RobbyV2/meenie_controller/docs/first-article/2026-10-17-nextpcb-sample/01-bottom-d3-polarity-marked.png

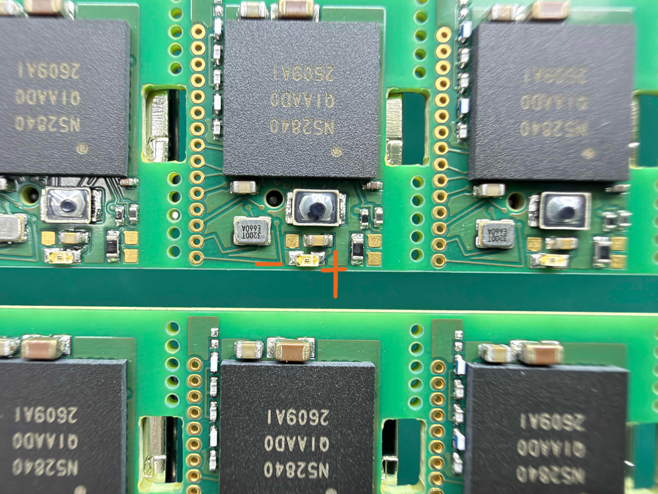
docs/first-article/2026-10-17-nextpcb-sample/01-bottom-d3-polarity-marked.png
