RobbyV2/meenie_controller/docs/first-article/2026-10-17-nextpcb-sample/02-bottom-closeup-a.png

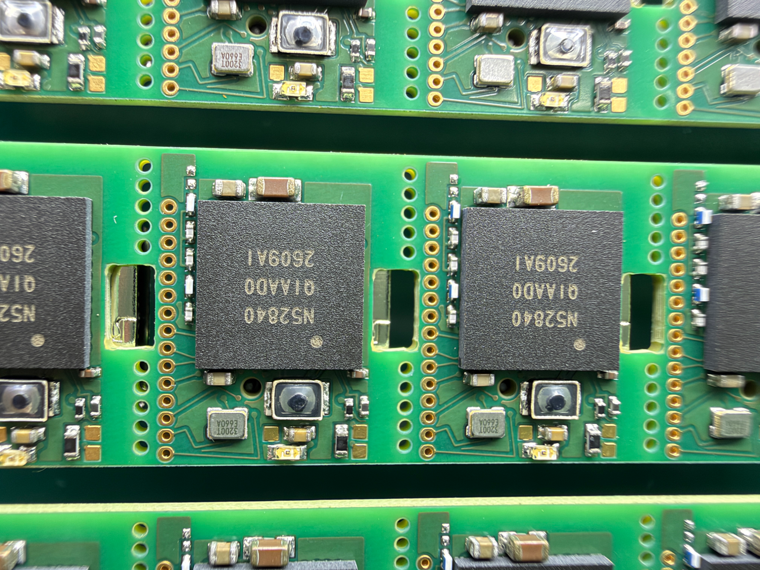
docs/first-article/2026-10-17-nextpcb-sample/02-bottom-closeup-a.png
