RobbyV2/meenie_controller/docs/first-article/2026-10-17-nextpcb-sample/03-bottom-closeup-b.png

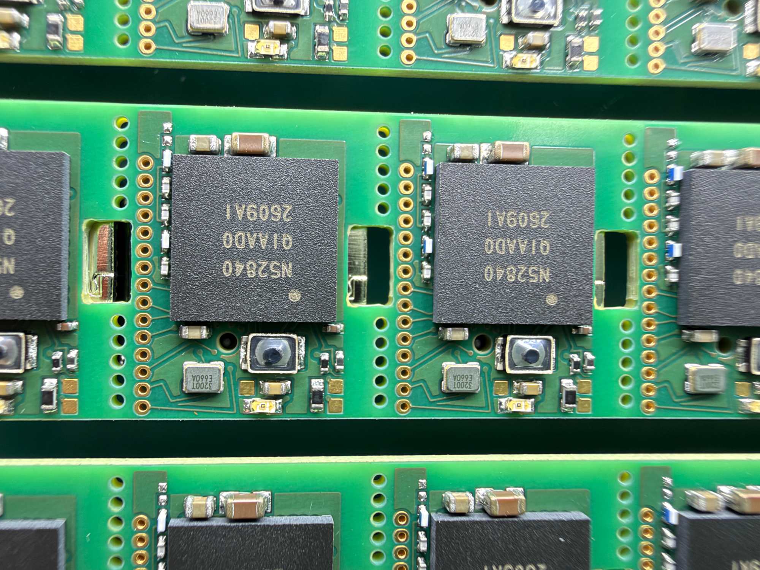
docs/first-article/2026-10-17-nextpcb-sample/03-bottom-closeup-b.png
