RobbyV2/meenie_controller/docs/first-article/2026-10-17-nextpcb-sample/04-bottom-panel.png

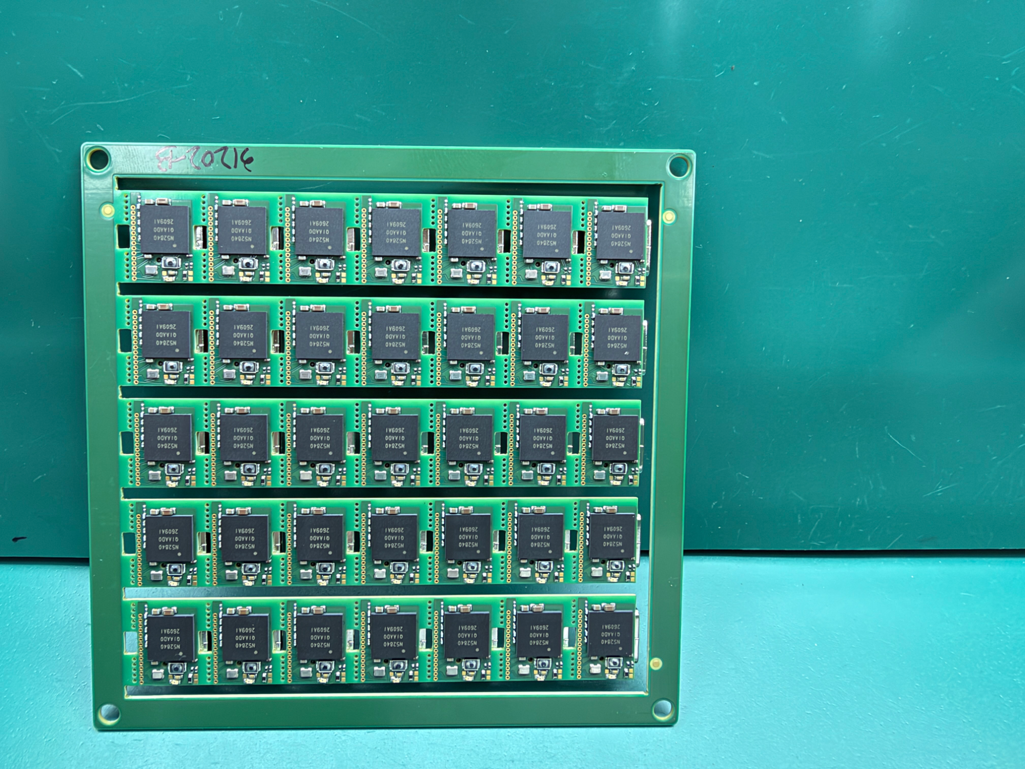
docs/first-article/2026-10-17-nextpcb-sample/04-bottom-panel.png
