RobbyV2/meenie_controller/docs/first-article/2026-10-17-nextpcb-sample/05-top-j1-closeup-a.png

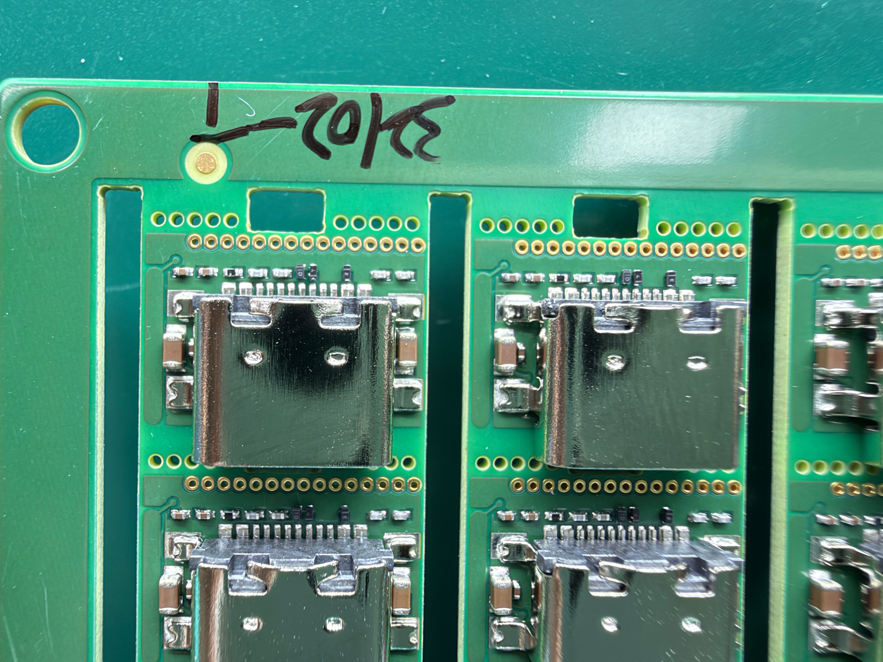
docs/first-article/2026-10-17-nextpcb-sample/05-top-j1-closeup-a.png
