RobbyV2/meenie_controller/docs/first-article/2026-10-17-nextpcb-sample/06-top-panel.png

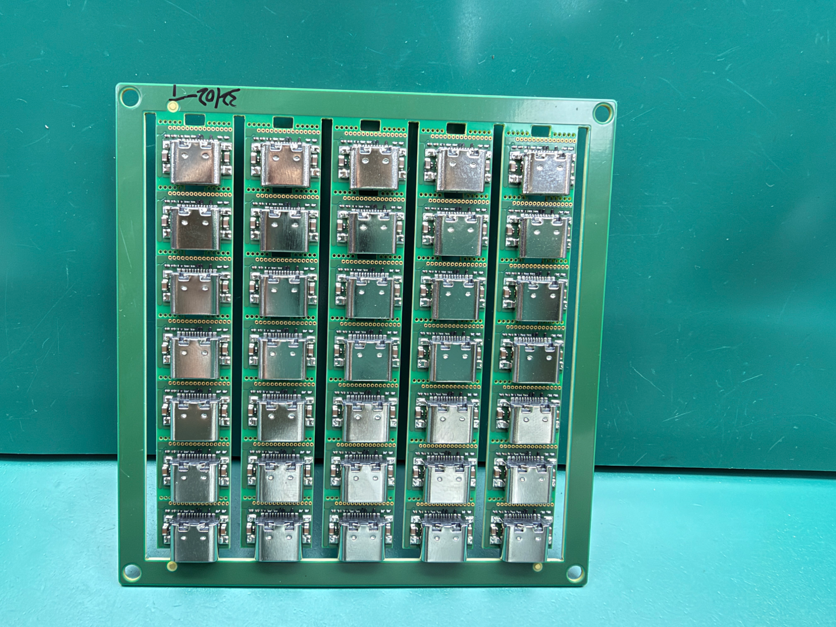
docs/first-article/2026-10-17-nextpcb-sample/06-top-panel.png
