RobbyV2/meenie_controller/docs/first-article/2026-10-17-nextpcb-sample/07-top-j1-closeup-b.png

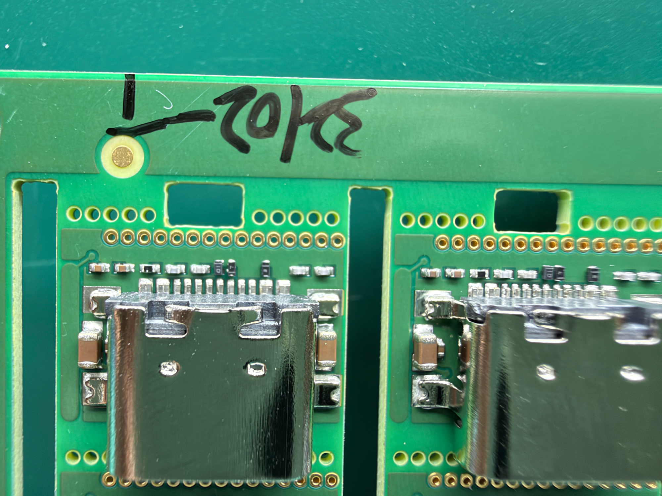
docs/first-article/2026-10-17-nextpcb-sample/07-top-j1-closeup-b.png
