RobbyV2/meenie_controller/docs/first-article/2026-10-17-nextpcb-sample/xray-u1-j1-b.jpg

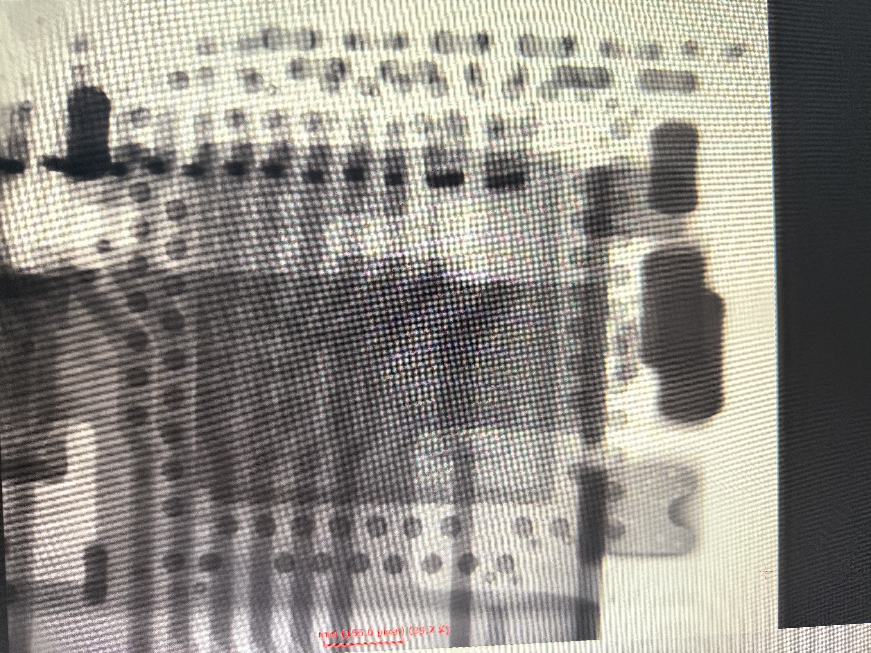
docs/first-article/2026-10-17-nextpcb-sample/xray-u1-j1-b.jpg
