RobbyV2/meenie_controller/fab/reports/nextpcb-dfa-T-E109823AA1.xlsx

NEXTPCB DFA report
Project Number：meenie-panel-0p15mm-gerbers |  | Prepared by: NextPCB |  |  |  |  | Date: 20260827
Item | Problem description 问题描述 | Reference location 影响位置 | MPN 物料名称 | Impact 影响 | Image 图片 | NextPCB Suggestion 建议 | Customer feedback 客户反馈 | Severity 严重度 | Status 状态
1 | Where is the cathode? | D2 D3 | / | There is no silk for that. |  | Please confirm. |  | Middle
2 | 35 boards are panelized together, need we de-panelize the boards before shippment? (separate the boards into individual boards) | panelized boards | / | We are not sure. |  | Please confirm. |  | Middle
