RobbyV2/meenie_controller/fab/board/raw-bom.csv

Designator | Value | Footprint | Quantity | LCSC Part | Manufacturer | MPN | DNP
C1 | 12pF C0G 2% | meenie:C0201 | 1 | C161404 | Murata | GRM0335C1H120GA01D
C2 | 12pF C0G 2% | meenie:C0201 | 1 | C161404 | Murata | GRM0335C1H120GA01D
C3 | 100nF | meenie:C0201 | 1 | C85923
C4 | 100nF | meenie:C0201_Murata_GRM033 | 1 | C85923 | Murata Electronics | GRM033C71C104KE14D
C5 | 100pF | meenie:C0201 | 1 | C272870
C6 | 10uF | meenie:C0402 | 1 | C3902158
C7 | 1.0uF | meenie:C0402 | 1 | C52923
C8 | 1.0uF | meenie:C0402 | 1 | C52923
C9 | 4.7uF | meenie:C0603 | 1 | C69335
C11 | 4.7uF | meenie:C0603 | 1 | C69335
C12 | 100nF | meenie:C0201 | 1 | C85923
C14 | 0.8pF | meenie:C0201 | 1 | C408126
C15 | 0.5pF | meenie:C0201 | 1 | C237424
C16 | 0.8pF | meenie:C0201 | 1 | C408126
C18 | 100nF | meenie:C0201 | 1 | C85923
C19 | 4.7uF | meenie:C0402 | 1 | C318563
C21 | 820pF | meenie:C0201 | 1 | C185597
D1 | TPD1E01B04DPLR | meenie:ESD_X2SON_DPL | 1 | C1972949 | Texas Instruments | TPD1E01B04DPLR
D2 | TPD1E6B06DPLR | meenie:ESD_X2SON_DPL | 1 | C914099 | Texas Instruments | TPD1E6B06DPLR
D3 | red | meenie:LED0402-R-RD_RED | 1 | C364556
D4 | ESD5311Z-2/TR | meenie:ESD_DFN0603-2 | 1 | C239819 | Will Semiconductor | ESD5311Z-2/TR
J1 | USB-C 16P sink | meenie:USB-TYPE-C-SMD_TYPE-C-16P-QTWT | 1 | C5187472 | SHOU HAN | TYPE-C 16P QTWT
L1 | 4.7nH | meenie:L0201 | 1 | C237443
L2 | 4.7nH | meenie:L0201 | 1 | C237443
R1 | 2R2 | meenie:R0402 | 1 | C327251
R2 | 5.1k | meenie:R0201 | 1 | C270344
R3 | 5.1k | meenie:R0201 | 1 | C270344
R4 | 1k | meenie:R0201 | 1 | C270365
SW1 | GSNANOT000102 | meenie:Switch_NanoT_AS | 1 |  | C&K/Littelfuse | GSNANOT000102
U1 | nRF52840-QIAA-R | meenie:AQFN-73_L7.0-W7.0-P0.50-BL-EP4.8 | 1 | C190794 | Nordic Semiconductor | NRF52840-QIAA-R
Y1 | FA-118T 32MHz CL 8pF | meenie:Crystal_SMD_1612-4Pin_FA-118T | 1 | C255986 | Seiko Epson | X1E0002510059
