RobbyV2/meenie_controller/fab/reports/assembly-summary.csv

variant | fitted_designators | bom_lines | unit_positions | panel_positions
A-4n7-0p5 | 31 | 23 | 31 | 1085
B-4n7-0p8 | 31 | 23 | 31 | 1085
C-3n9-DNP | 30 | 24 | 30 | 1050
D-3n9-2p4 | 31 | 25 | 31 | 1085
