RobbyV2/meenie_controller/hw/meenie.kicad_pcb

## KiCad design hw/meenie.kicad_pcb (2026-08-12)

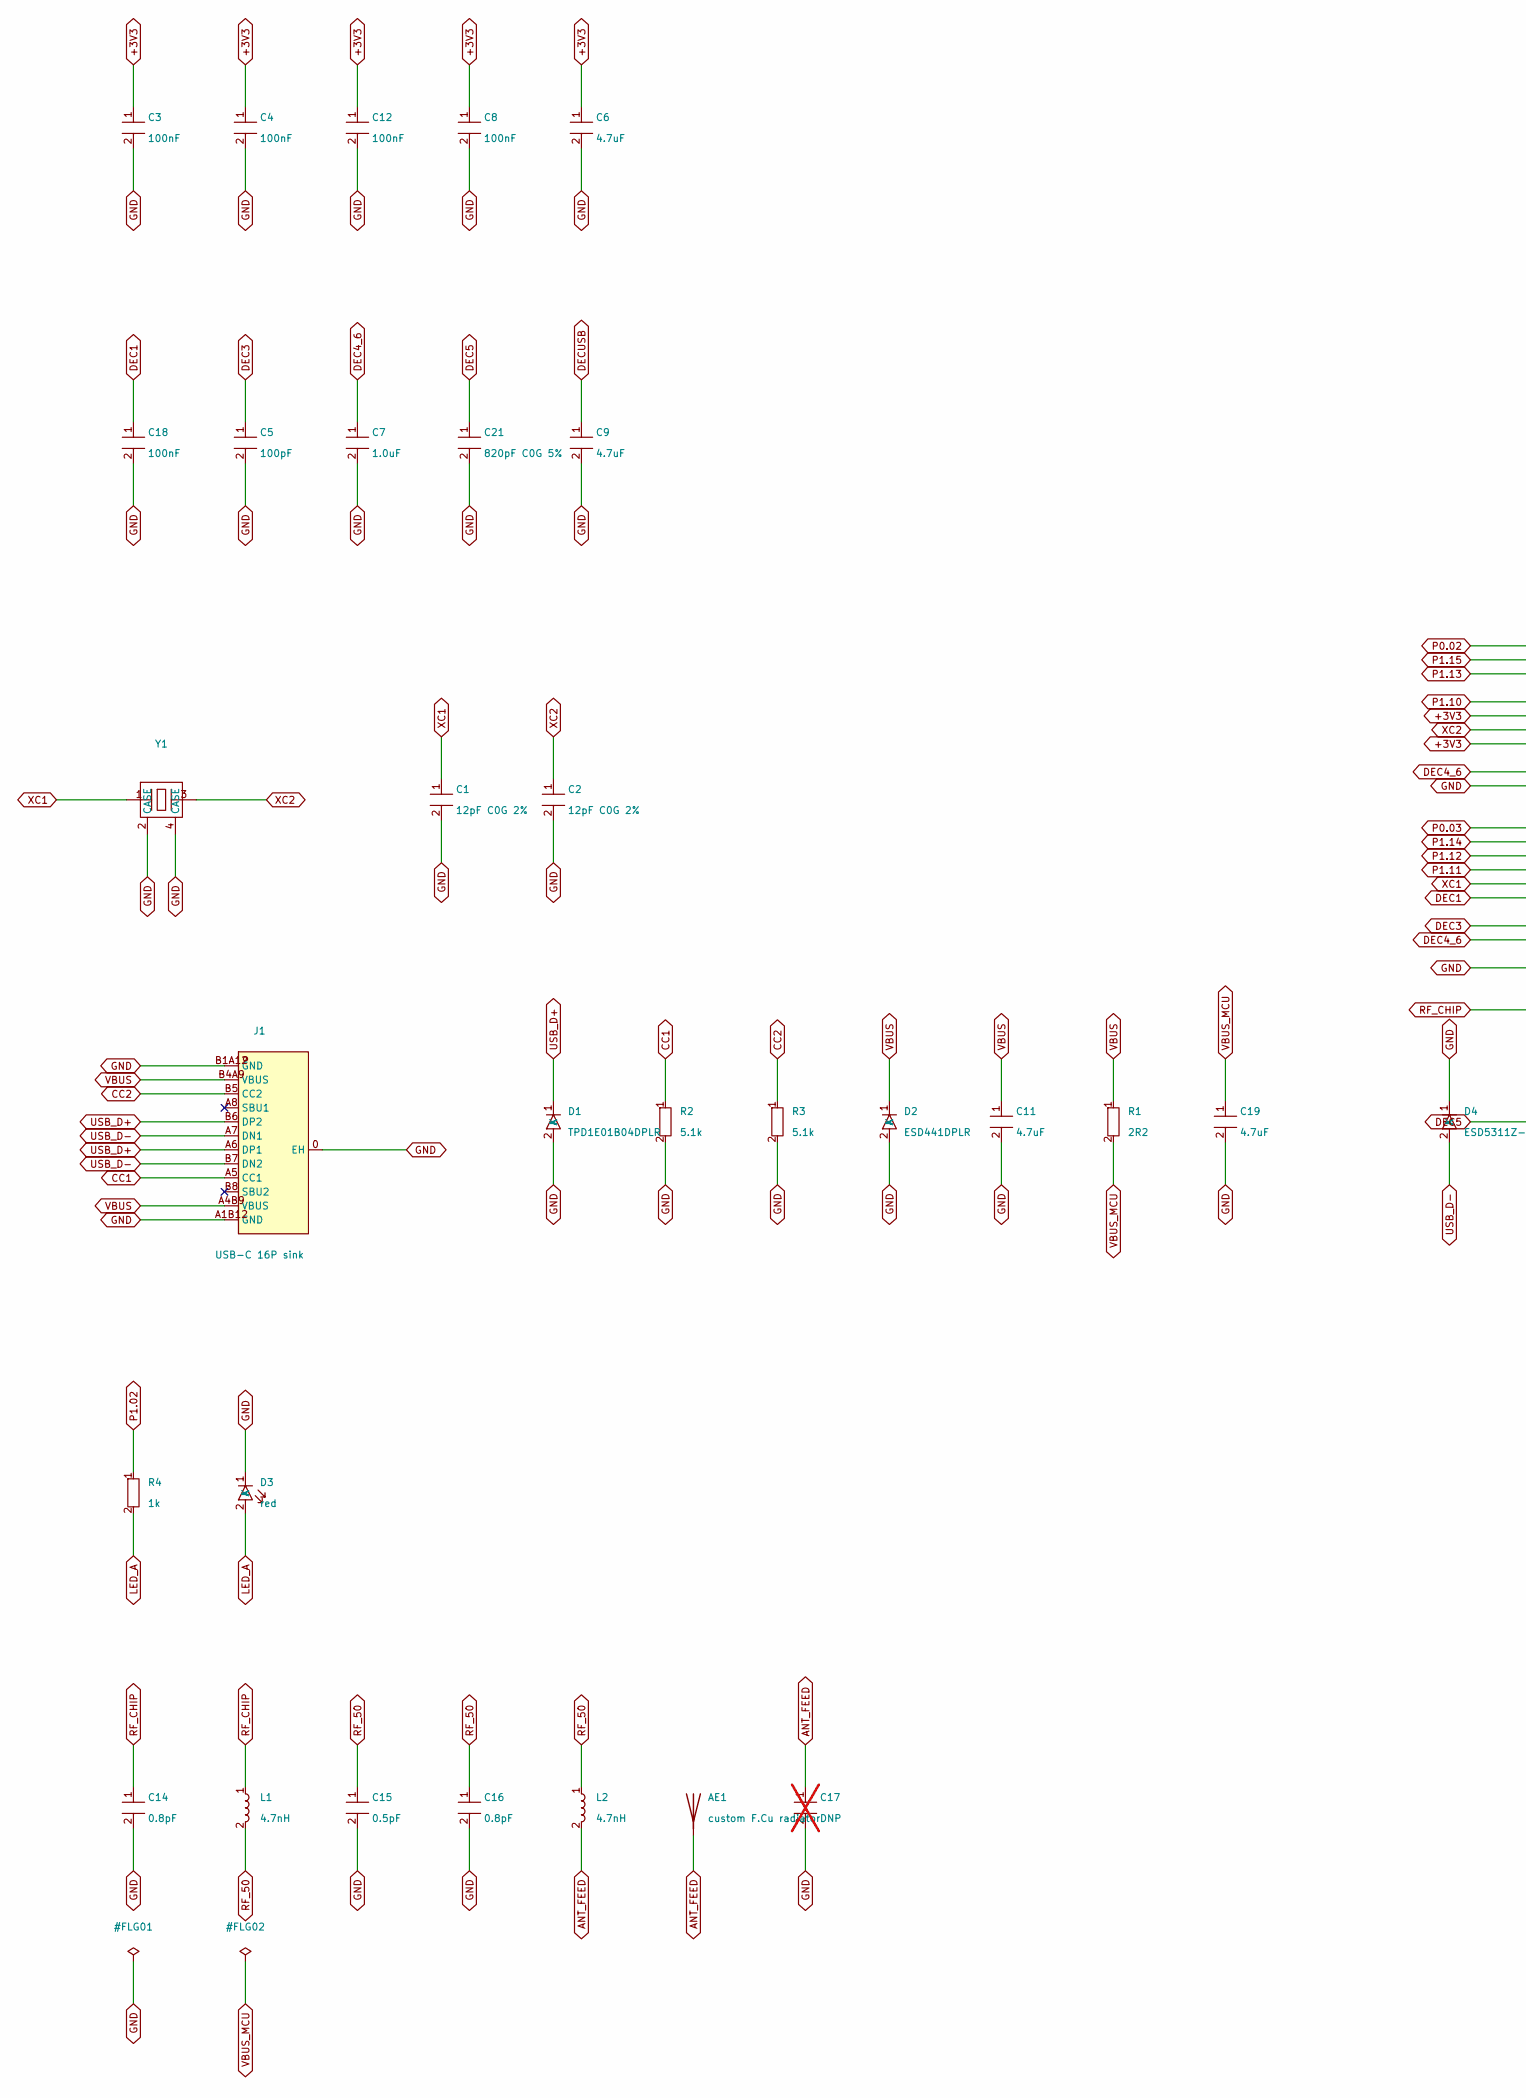
[picture p13: schematic meenie.kicad_sch, meenie controller, part in row 1, column 1]

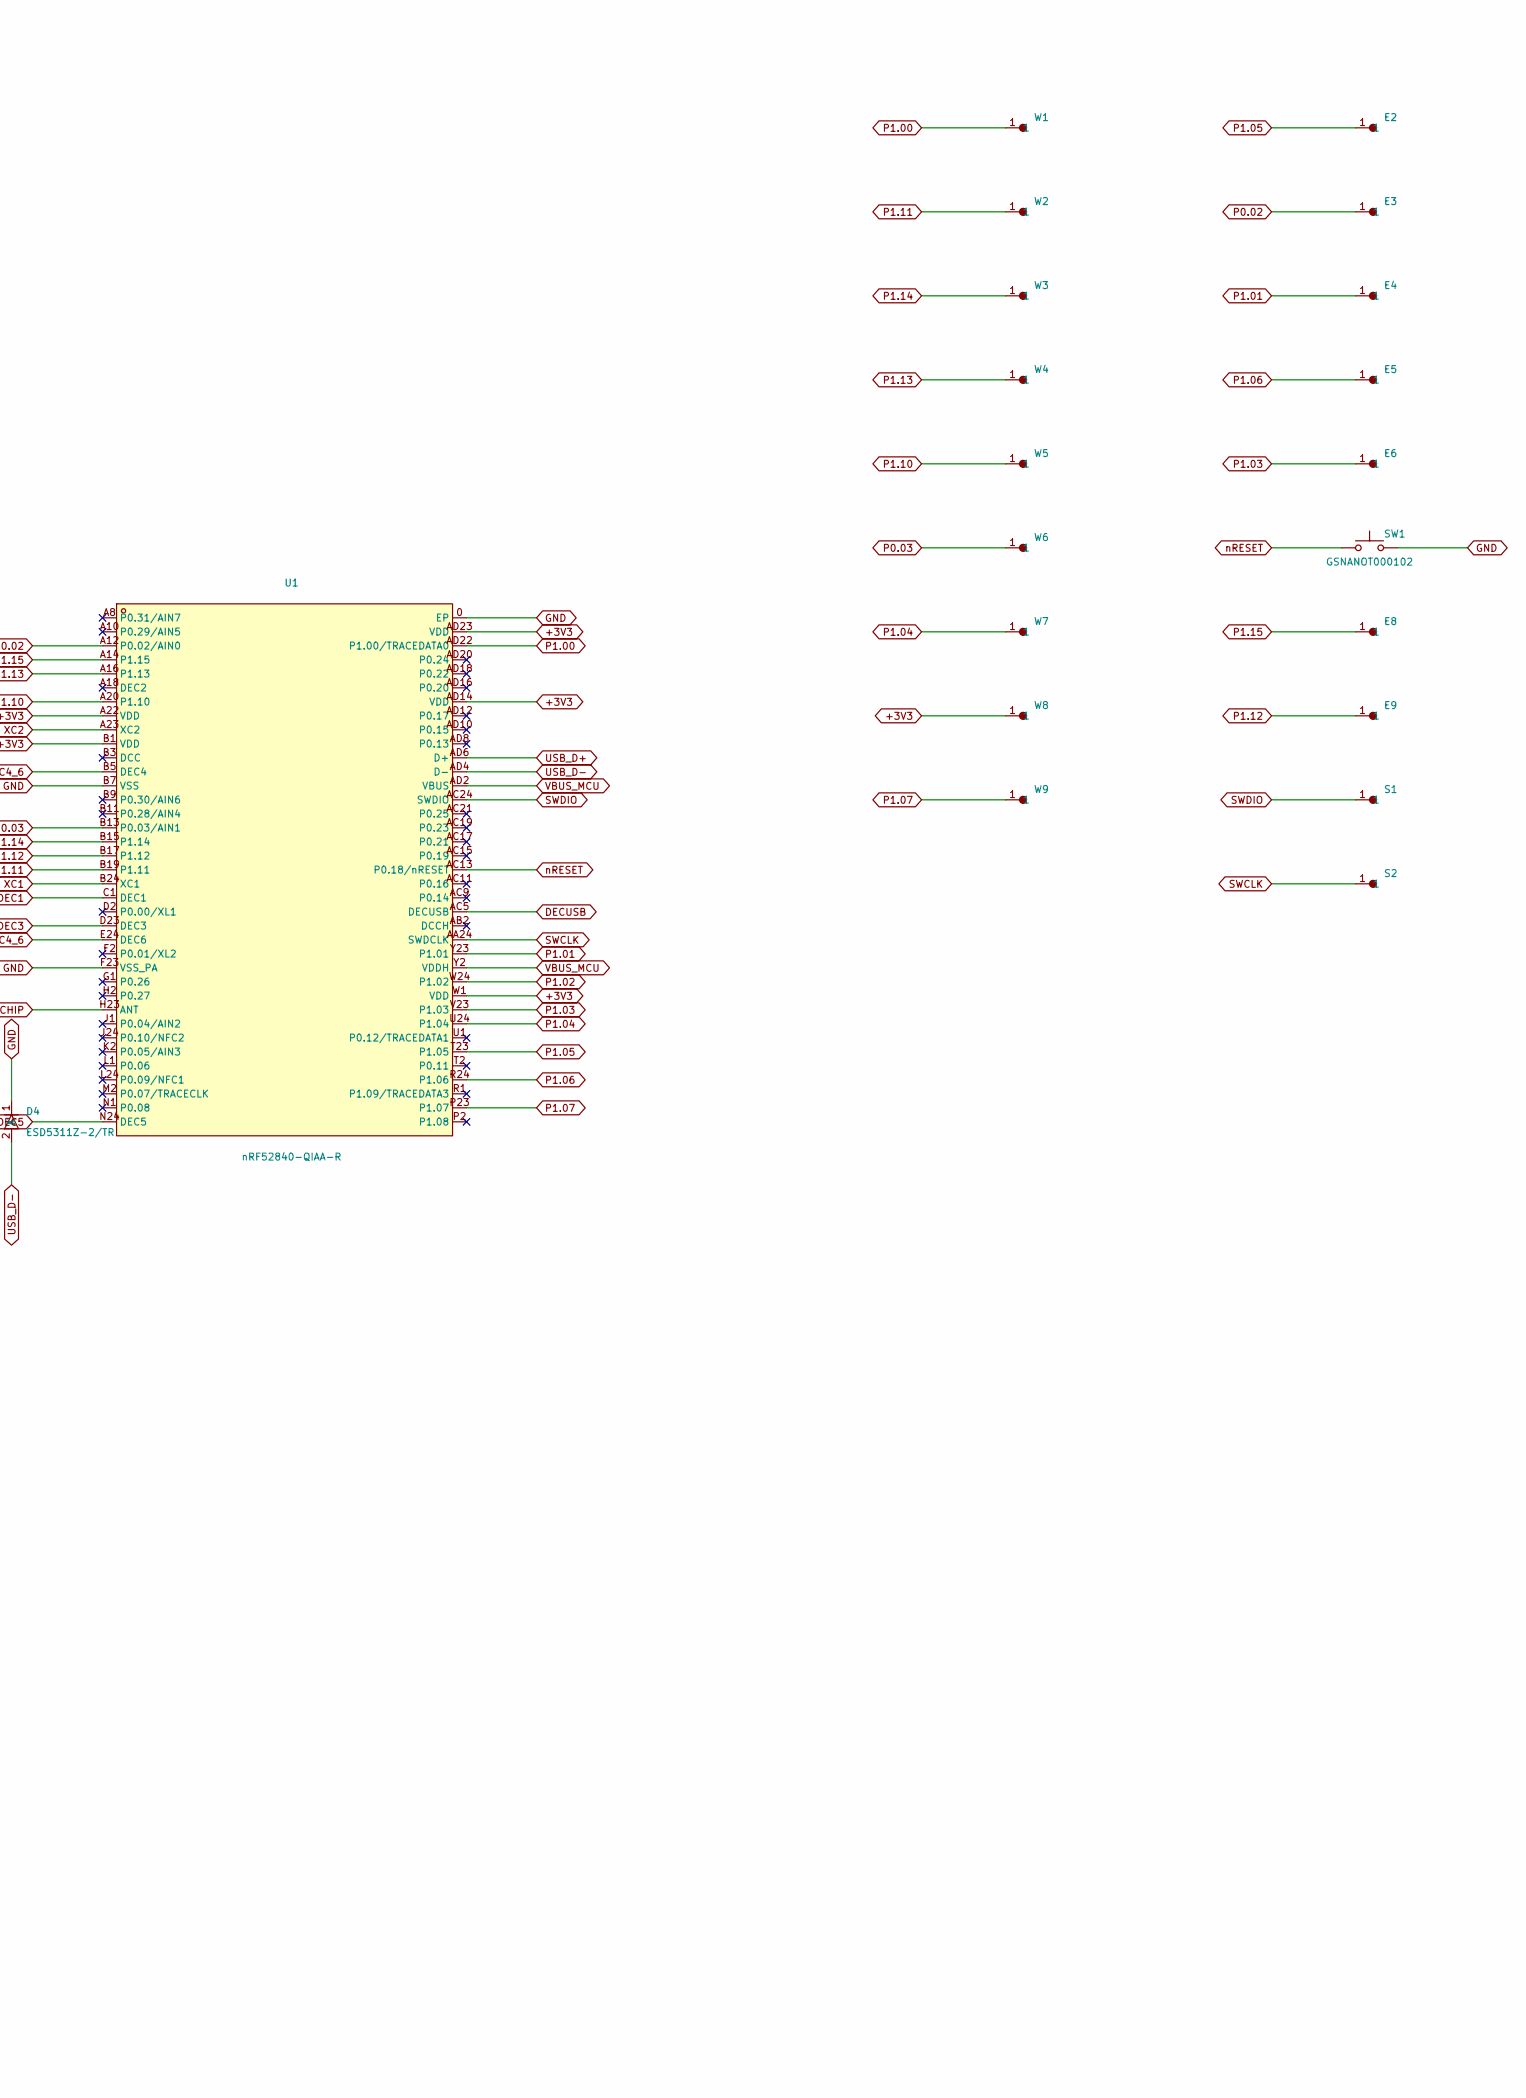
[picture p14: schematic meenie.kicad_sch, meenie controller, part in row 1, column 2]

Parts:
AE1: custom F.Cu radiator
C1, C2: 12pF C0G 2%; C0201; MPN GRM0335C1H120GA01D; LCSC Part C161404
C3, C12, C18: 100nF; C0201; MPN GRM033C71C104KE14D; LCSC Part C85923
C4: 100nF; C0201_Murata_GRM033; MPN GRM033C71C104KE14D; LCSC Part C85923
C5: 100pF; C0201; MPN CC0201JRNPO9BN101; LCSC Part C272870
C6: 4.7uF; C0603; Manufacturer Part Number GRM188R61E475KE11D; LCSC Part C90057
C7: 1.0uF; C0402; MPN CL05A105KA5NQNC; LCSC Part C52923
C8: 100nF; C0402; Manufacturer Part Number CL05B104KO5NNNC; LCSC Part C1525
C9, C11: 4.7uF; C0603; MPN GRM188R61E475KE11D; LCSC Part C90057
C14, C16: 0.8pF; C0201; MPN GJM0335C1ER80WB01D; LCSC Part C408126
C15: 0.5pF; C0201; MPN GJM0335C1HR50WB01D; LCSC Part C237424
C17: DNP; C0201; LCSC Part NOT SELECTED; not fitted
C19: 4.7uF; C0402; Manufacturer Part Number CL05A475MO5NUNC; LCSC Part C318563
C21: 820pF C0G 5%; C0201; MPN GRM0335C1E821JA01D; LCSC Part C384953
D1: TPD1E01B04DPLR; ESD_X2SON_DPL; MPN TPD1E01B04DPLR; LCSC Part C1972949
D2: ESD441DPLR; ESD_X2SON_DPL; MPN ESD441DPLR; LCSC Part C22427765
D3: red; LED0402-R-RD_RED; MPN LTST-C281KRKT; LCSC Part C364556
D4: ESD5311Z-2/TR; ESD_DFN0603-2; MPN ESD5311Z-2/TR; LCSC Part C239819
E2, E3, E4, E5, E6, E8, E9: pad; TestPad_0.6mm_PTH
J1: USB-C 16P sink; USB-TYPE-C-SMD_TYPE-C-16P-QTWT; MPN TYPE-C 16P QTWT; LCSC Part C5187472
L1, L2: 4.7nH; L0201; MPN LQP03HQ4N7H02D; LCSC Part C237443
R1: 2R2; R0402; MPN RC0402FR-072R2L; LCSC Part C327251
R2, R3: 5.1k; R0201; MPN RC0201FR-075K1L; LCSC Part C274341
R4: 1k; R0201; MPN 0201WMF1001TEE; LCSC Part C270365
S1, S2: pad; TestPad_0.6mm
SW1: GSNANOT000102; Switch_NanoT_AS; MPN GSNANOT000102; DigiKey Part 108-NANOT160ASCT-ND
U1: nRF52840-QIAA-R; AQFN-73_L7.0-W7.0-P0.50-BL-EP4.8; MPN NRF52840-QIAA-R; LCSC Part C190794
W1, W2, W3, W4, W5, W6, W7, W9: pad; TestPad_0.6mm_PTH
W8: pad; TestPad_0.6mm
Y1: FA-118T 32MHz CL 8pF; Crystal_SMD_1612-4Pin_FA-118T; MPN X1E0002510059; LCSC Part C255986

Connections:
+3V3: C3.1, C4.1, C6.1, C8.1, C12.1, U1.A22 (VDD), U1.AD14 (VDD), U1.AD23 (VDD), U1.B1 (VDD), U1.W1 (VDD), W8.1
ANT_FEED: AE1.1, C17.1, L2.2
CC1: J1.A5 (CC1), R2.1
CC2: J1.B5 (CC2), R3.1
DEC1: C18.1, U1.C1 (DEC1)
DEC3: C5.1, U1.D23 (DEC3)
DEC4_6: C7.1, U1.B5 (DEC4), U1.E24 (DEC6)
DEC5: C21.1, U1.N24 (DEC5)
DECUSB: C9.1, U1.AC5 (DECUSB)
GND: C1.2, C2.2, C3.2, C4.2, C5.2, C6.2, C7.2, C8.2, C9.2, C11.2, C12.2, C14.2, C15.2, C16.2, C17.2, C18.2, C19.2, C21.2, D1.2 (A), D2.2 (A), D3.1 (K), D4.1 (K), J1.0 (EH), J1.A1B12 (GND), J1.B1A12 (GND), R2.2, R3.2, SW1.2, U1.0 (EP), U1.B7 (VSS), U1.F23 (VSS_PA), Y1.2 (CASE), Y1.4 (CASE)
LED_A: D3.2 (A), R4.2
P0.02: E3.1, U1.A12 (P0.02/AIN0)
P0.03: U1.B13 (P0.03/AIN1), W6.1
P1.00: U1.AD22 (P1.00/TRACEDATA0), W1.1
P1.01: E4.1, U1.Y23 (P1.01)
P1.02: R4.1, U1.W24 (P1.02)
P1.03: E6.1, U1.V23 (P1.03)
P1.04: U1.U24 (P1.04), W7.1
P1.05: E2.1, U1.T23 (P1.05)
P1.06: E5.1, U1.R24 (P1.06)
P1.07: U1.P23 (P1.07), W9.1
P1.10: U1.A20 (P1.10), W5.1
P1.11: U1.B19 (P1.11), W2.1
P1.12: E9.1, U1.B17 (P1.12)
P1.13: U1.A16 (P1.13), W4.1
P1.14: U1.B15 (P1.14), W3.1
P1.15: E8.1, U1.A14 (P1.15)
RF_50: C15.1, C16.1, L1.2, L2.1
RF_CHIP: C14.1, L1.1, U1.H23 (ANT)
SWCLK: S2.1, U1.AA24 (SWDCLK)
SWDIO: S1.1, U1.AC24 (SWDIO)
USB_D+: D1.1 (K), J1.A6 (DP1), J1.B6 (DP2), U1.AD6 (D+)
USB_D-: D4.2 (A), J1.A7 (DN1), J1.B7 (DN2), U1.AD4 (D-)
VBUS: C11.1, D2.1 (K), J1.A4B9 (VBUS), J1.B4A9 (VBUS), R1.1
VBUS_MCU: C19.1, R1.2, U1.AD2 (VBUS), U1.Y2 (VDDH)
XC1: C1.1, U1.B24 (XC1), Y1.1
XC2: C2.1, U1.A23 (XC2), Y1.3
nRESET: SW1.1, U1.AC13 (P0.18/nRESET)

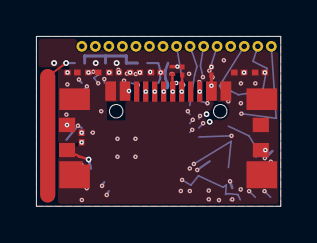
[picture p15: board meenie.kicad_pcb from above]

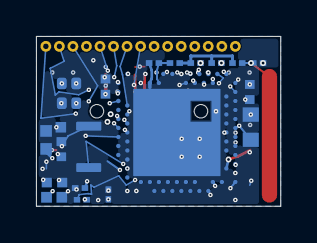
[picture p16: board meenie.kicad_pcb from below]

Board: 8 copper layers, 13.6 x 9.4 mm, 50 parts (22 on the bottom side), 38 nets.
